Pahansith7/Electronic_Design_Realization_Project/Video and Images/Image_3.jpeg

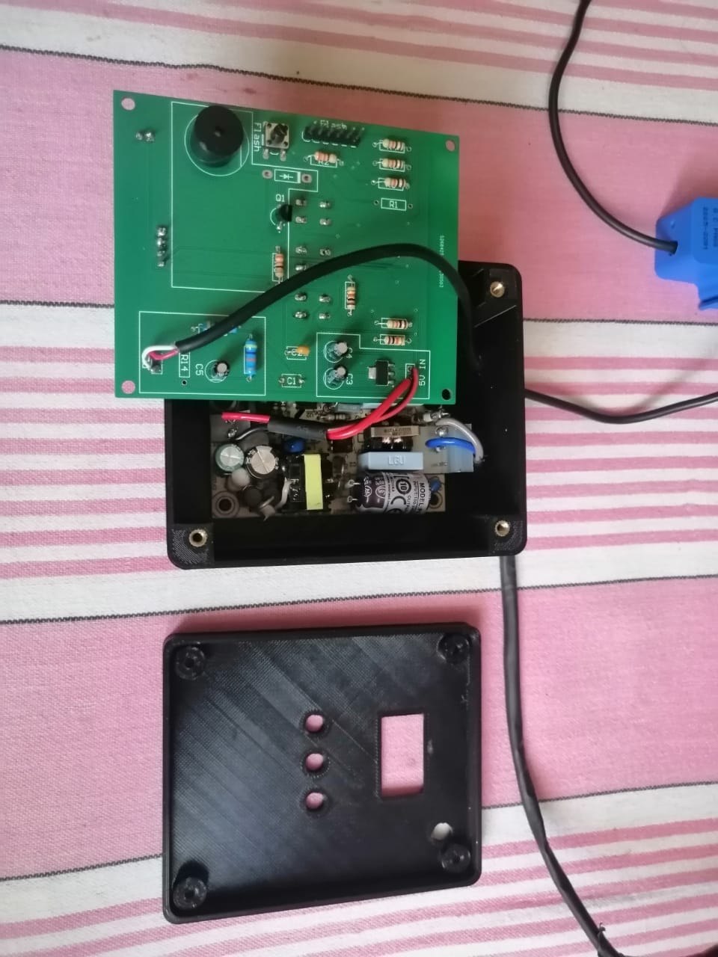
Video and Images/Image_3.jpeg
