Pahansith7/Electronic_Design_Realization_Project/README.md

# Smart Energy Meter

---

Designed and developed a smart energy monitoring system to measure real-time power consumption and provide actionable insights for minimizing power wastage and reducing electricity bills.

---
