Pahansith7/Electronic_Design_Realization_Project/Video and Images/Image_2.jpeg

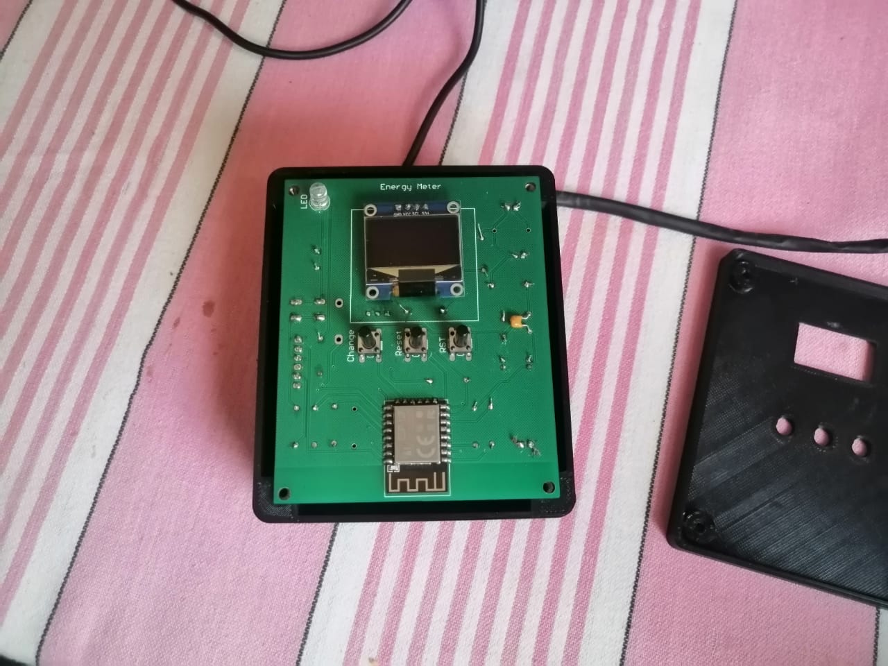
Video and Images/Image_2.jpeg
