Pahansith7/Electronic_Design_Realization_Project/Components Used and Suppliers.pdf

Components & Suppliers

### 1. Current Sensor- SCT013 30A

Amazon Link (https://www.amazon.com/JANSANE-SCT-013-030-Non-invasive-Split-Core-Transformer/dp/B07JNDRJQ4)

### 2. Power Supply Unit – SMPS

Mouser Link (https://www.mouser.com/ProductDetail/MEAN-WELL/PS-05-5?qs=pqZ7J9Gt%2FmrLjF0GsFyr0A%3D%3D)

### 3. OLED Display

Supplier Link (ELECROW) (https://www.elecrow.com/i2c-096-oled-128x64-blueyellow-p-1086.html)

### 4. ESP 8266 microcontroller

Supplier Link (ELECROW) (https://www.elecrow.com/i2c-096-oled-128x64-blueyellow-p-1086.html)

### 5. Other Circuit Components 5.1 Buzzer

Mouser Link (https://www.mouser.com/ProductDetail/490-CMI-1295IC-0385T)
5.2 100nF Capacitor
Mouser Link (https://www.mouser.com/ProductDetail/594-K104K15X7RF5TH5)
5.3 10uF capacitor
Mouser Link (https://www.mouser.com/ProductDetail/Panasonic/ECE-A1CN100U?qs=sGAEpiMZZMvwFf0viD3Y3ZRFQPN8JpgPVNShkXyEkW8%3D)

### 5.4 AMS 1117 3.3V

Mouser Link (https://www.mouser.com/ProductDetail/Texas-Instruments/REG1117-3.3G4?qs=quKhnJqH4FhyowGGftIF6w%3D%3D)
5.5 10K Resistors (Local Market)

5.6 330Ω Resistor (Local Market)

### 5.7 BC 547 Transistor (Local Market)

### 5.8 Protection Diode 1N5819 (Local Market)

### 5.9 LED 5.10 Tac Switches (Push Buttons) (Local Market)
