Pahansith7/Electronic_Design_Realization_Project/SOLIDWORKS_Desig_Files/Bottom Part.SLDPRT

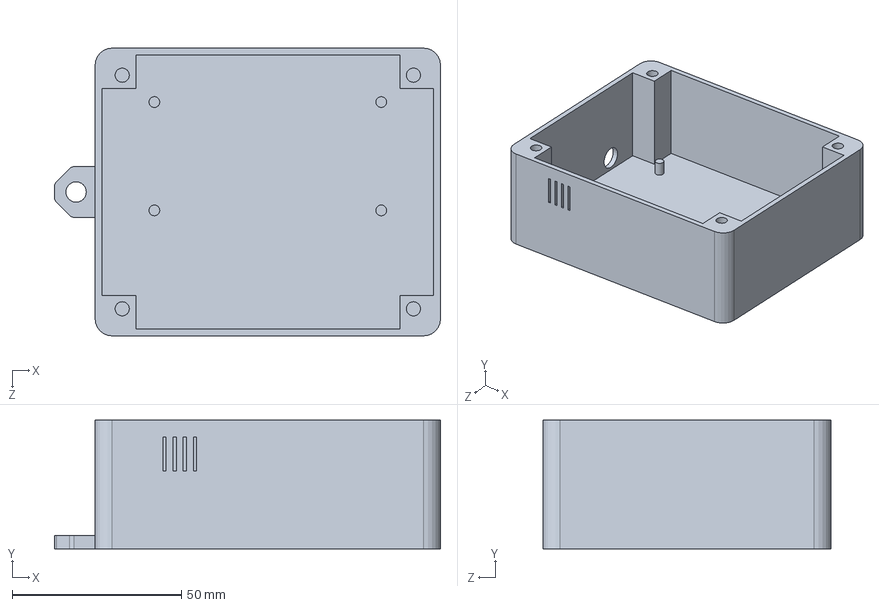
[picture p39: CAD file, 2023-08-25]
SOLIDWORKS_Desig_Files/Bottom Part.SLDPRT
114.0 x 38.0 x 85.0 mm
