Pahansith7/Electronic_Design_Realization_Project/SOLIDWORKS_Desig_Files/top.SLDPRT

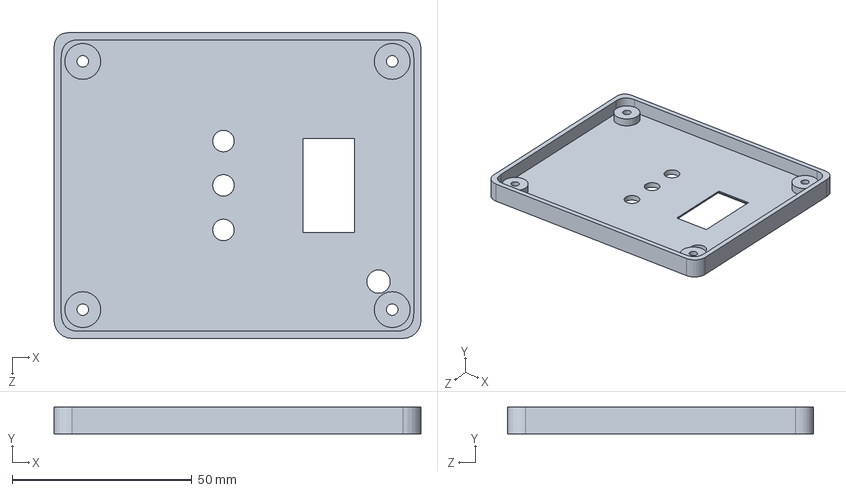
[picture p40: CAD file, 2023-08-25]
SOLIDWORKS_Desig_Files/top.SLDPRT
102.0 x 7.50 x 85.0 mm
