Pahansith7/Electronic_Design_Realization_Project/(list of files, drawings)

Other design files:
PCB_Design_FIles/SmartEnergyMeter_PCB.PcbDoc
PCB_Design_FIles/SmartEnergyMeter_schematic.SchDoc
